brrastak/garland_controller/electronic/output/garland_controller.step

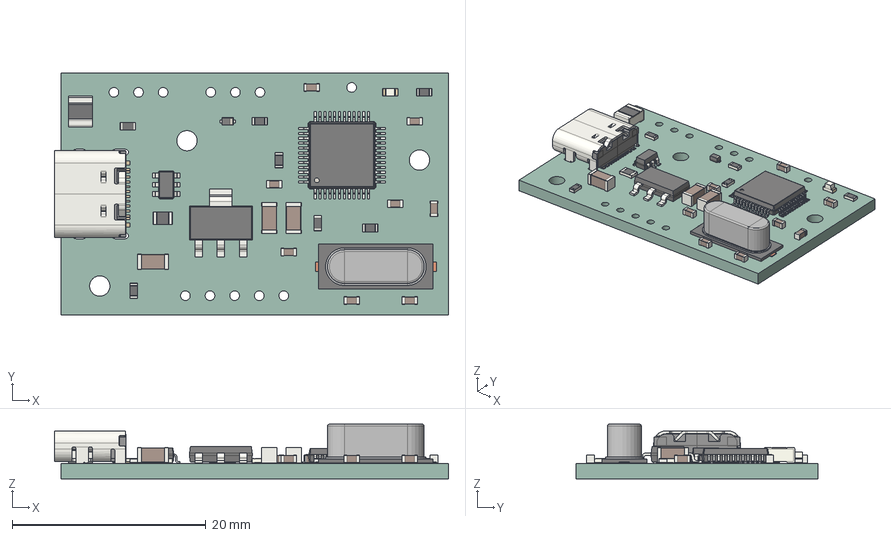
[picture p1: CAD file, 2025-02-09]
electronic/output/garland_controller.step
40.7 x 25.0 x 5.65 mm
R_0603_1608Metric x 7
LED_0603_1608Metric
C_0603_1608Metric x 8
C_1206_3216Metric x 3
Fuse_1210_3225Metric
SOT_23_6
SOT_223
LQFP_48_7x7mm_P05mm
USB_C_Receptacle_16P_TopMnt_Horizontal_GCT_USB4105-xx-A
Crystal_SMD_HC49-SD
Fuse_0805_2012Metric
D_SOD_523
garland_controller_PCB
