brrastak/garland_controller/(list of files, cad)

Other CAD files:
enclosure/openscad/YAPPgenerator_v3.scad
