brrastak/garland_controller/electronic/garland_controller.kicad_pcb

## KiCad design electronic/garland_controller.kicad_pcb (2025-02-10)

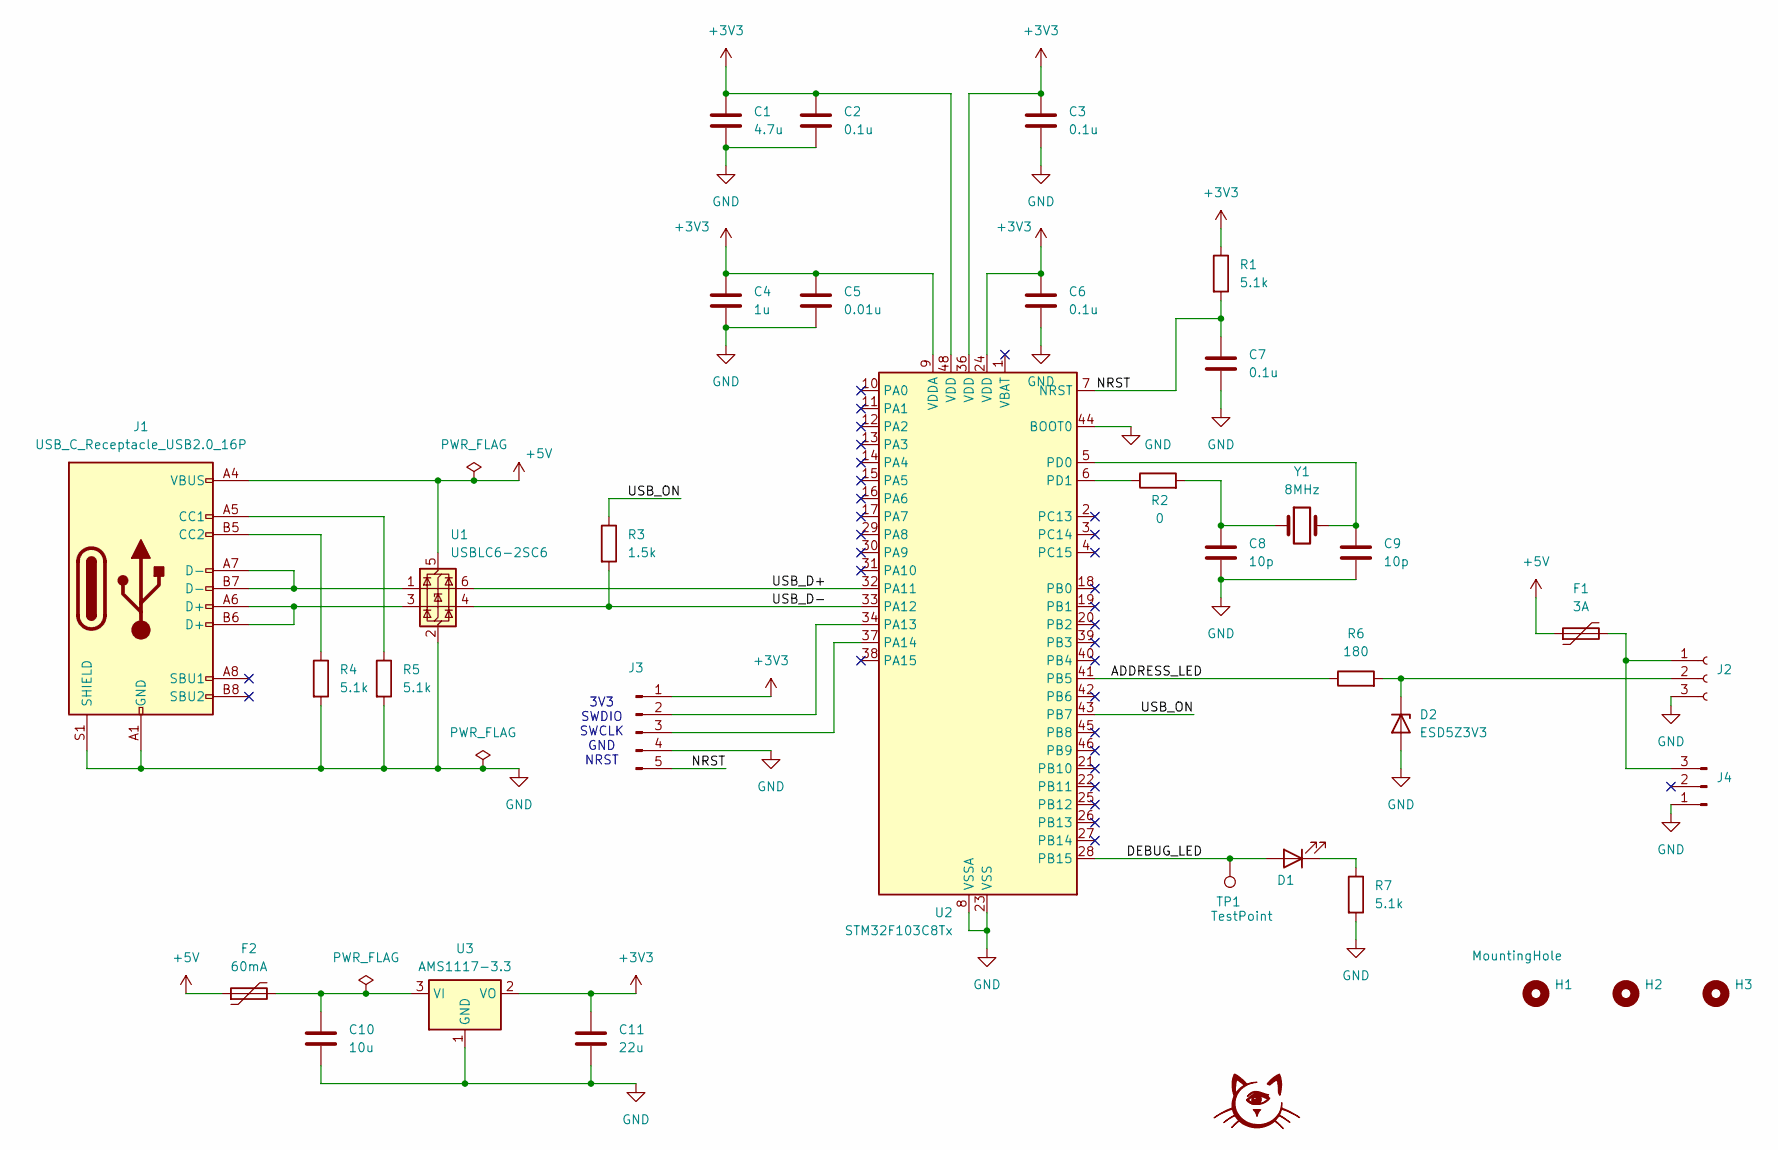
[picture p3: schematic garland_controller.kicad_sch, Garland controller]

Parts:
C1: 4.7u; C_1206_3216Metric_Pad1.33x1.80mm_HandSolder
C2, C3, C6, C7: 0.1u; C_0603_1608Metric_Pad1.08x0.95mm_HandSolder
C4: 1u; C_0603_1608Metric_Pad1.08x0.95mm_HandSolder
C5: 0.01u; C_0603_1608Metric_Pad1.08x0.95mm_HandSolder
C8, C9: 10p; C_0603_1608Metric_Pad1.08x0.95mm_HandSolder
C10: 10u; C_1206_3216Metric_Pad1.33x1.80mm_HandSolder
C11: 22u; C_1206_3216Metric_Pad1.33x1.80mm_HandSolder
D1: LED; LED_0603_1608Metric_Pad1.05x0.95mm_HandSolder
D2: ESD5Z3V3; D_SOD-523
F1: 3A; Fuse_1210_3225Metric_Pad1.42x2.65mm_HandSolder
F2: 60mA; Fuse_0805_2012Metric_Pad1.15x1.40mm_HandSolder
G1: stamp
H1, H2, H3: MountingHole; MountingHole_2.1mm
J1: USB_C_Receptacle_USB2.0_16P; USB_C_Receptacle_GCT_USB4105-xx-A_16P_TopMnt_Horizontal
J2: Conn_01x03_Socket; PinHeader_1x03_P2.54mm_Vertical
J3: Conn_01x05_Pin; PinHeader_1x05_P2.54mm_Vertical
J4: Conn_01x03_Pin; PinHeader_1x03_P2.54mm_Vertical
R1, R4, R5, R7: 5.1k; R_0603_1608Metric_Pad0.98x0.95mm_HandSolder
R2: 0; R_0603_1608Metric_Pad0.98x0.95mm_HandSolder
R3: 1.5k; R_0603_1608Metric_Pad0.98x0.95mm_HandSolder
R6: 180; R_0603_1608Metric_Pad0.98x0.95mm_HandSolder
TP1: TestPoint; PinHeader_1x01_P2.54mm_Vertical
U1: USBLC6-2SC6; SOT-23-6
U2: STM32F103C8Tx; LQFP-48_7x7mm_P0.5mm
U3: AMS1117-3.3; SOT-223-3_TabPin2
Y1: 8MHz; Crystal_SMD_HC49-SD

Connections:
+3V3: C1.1, C2.1, C3.1, C4.1, C5.1, C6.1, C11.1, J3.1, R1.1, U2.9 (VDDA), U2.24 (VDD), U2.36 (VDD), U2.48 (VDD), U3.2 (VO)
+5V: F1.1, F2.1, J1.A4 (VBUS), J1.A9 (VBUS), J1.B4 (VBUS), J1.B9 (VBUS), U1.5 (VBUS)
/ADDRESS_LED: R6.1, U2.41 (PB5)
/DEBUG_LED: D1.2 (A), TP1.1, U2.28 (PB15)
/NRST: C7.1, J3.5, R1.2, U2.7 (NRST)
/USB_D+: U1.6 (I/O1), U2.32 (PA11)
/USB_D-: R3.2, U1.4 (I/O2), U2.33 (PA12)
/USB_ON: R3.1, U2.43 (PB7)
GND: C1.2, C2.2, C3.2, C4.2, C5.2, C6.2, C7.2, C8.2, C9.2, C10.2, C11.2, D2.2 (A), J1.A1 (GND), J1.A12 (GND), J1.B1 (GND), J1.B12 (GND), J1.S1 (SHIELD), J2.3, J3.4, J4.1, R4.2, R5.2, R7.2, U1.2 (GND), U2.8 (VSSA), U2.23 (VSS), U2.35 (VSS), U2.44 (BOOT0), U2.47 (VSS), U3.1 (GND)
unnamed: C8.1, R2.2, Y1.1
unnamed: D1.1 (K), R7.1
unnamed: D2.1 (K), J2.2, R6.2
unnamed: J1.A5 (CC1), R5.1
unnamed: J1.B5 (CC2), R4.1
unnamed: J1.A6 (D+), J1.B6 (D+), U1.3 (I/O2)
unnamed: J1.A7 (D-), J1.B7 (D-), U1.1 (I/O1)
unnamed: F1.2, J2.1, J4.3
unnamed: J3.2, U2.34 (PA13)
unnamed: J3.3, U2.37 (PA14)
unnamed: C9.1, U2.5 (PD0), Y1.2
unnamed: R2.1, U2.6 (PD1)
unnamed: C10.1, F2.2, U3.3 (VI)

Notes on the sheet:
3V3 SWDIO SWCLK GND NRST

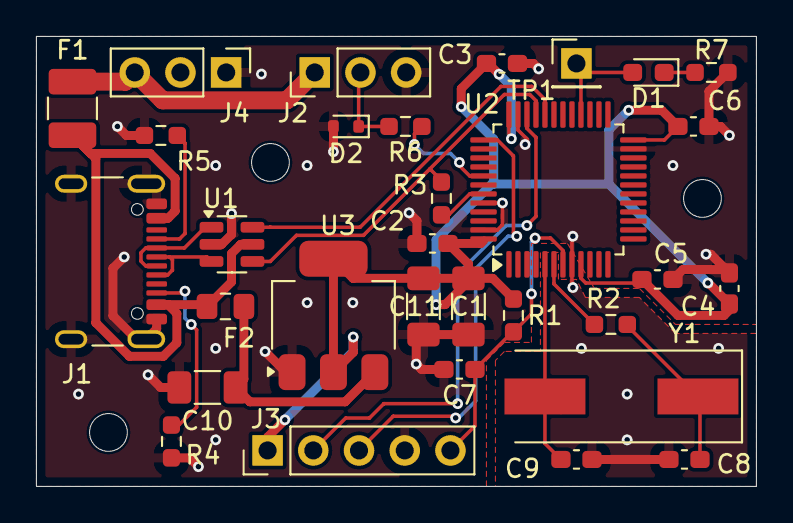
[picture p4: board garland_controller.kicad_pcb from above]

Board: 2 copper layers, 40.0 x 25.0 mm, 35 parts (1 on the bottom side), 22 nets.
