brrastak/garland_controller/(commit log)

2025-02-09 Init schematic
    [garland_controller.kicad_pcb, garland_controller.kicad_sch]
2025-02-09 Place components
    [garland_controller.kicad_pcb, garland_controller.kicad_sch]
2025-02-09 Add generated box and lid
    [YAPPgenerator_v3.scad, box.scad]
2025-02-09 Tune fuses
    [garland_controller.kicad_pcb, garland_controller.kicad_sch]
2025-02-09 Layout rev. 0.1
    [garland_controller.kicad_pcb, garland_controller.kicad_sch, garland_controller.step]
2025-02-10 Add gerber files
    [garland_controller-B_Cu.gbl, garland_controller-B_Mask.gbs, garland_controller-B_Paste.gbp, garland_controller-B_Silkscreen.gbo, garland_controller-Edge_Cuts.gm1, garland_controller-F_Cu.gtl, garland_controller-F_Mask.gts, garland_controller-F_Paste.gtp]
2025-03-19 Move holes and add ridges
    [box.scad]
